Essenceia/Teapot/(commit log)

2026-05-21 adding rmii config straps
2026-05-27 applying more aggressive filtering
2026-06-02 moved comparison in main test file, creating main comparison between expected and go for tx eth frame
2026-06-04 finish fixing bit ordering issue on app
    [app_utils.py, app_wrapper.v]
2026-06-10 restore correct mac address now that I can give it as an cli arg
    [main.c]
2026-06-10 moved to using the cheap amanzone phy board
2026-06-12 testing in medium loopback mode, still can't figure out the issue
    [app_wrapper.v, basys3.xdc, emulator.v, mac_rx.v, mac_tx.v, tx_cdc.v, tx_tt_buffer.v]
2026-06-13 merged fcs and other fixes
    [crc_8.v, io_switch.v, mac_tx.v, mac_utils.py, main.c, test.py]
2026-06-15 expect assert error in gate mode
    [test.py]
2026-06-15 skip test on gl
    [test.py]
2026-06-15 add config device mac changed test
